Thore-Krug/Dev_Kit-Hardware/README.md

# Dev_Kit-Hardware

The C.H.I.P. Pro Dev Kit integrates a C.H.I.P. Pro. 
More information on C.H.I.P Pro can be found here: [C.H.I.P Pro - Hardware](https://github.com/NextThingCo/CHIP_Pro-Hardware)
