Thore-Krug/Dev_Kit-Hardware/Mechanical/Dev-Kit-v1.0-Mechanical_Diagram.png

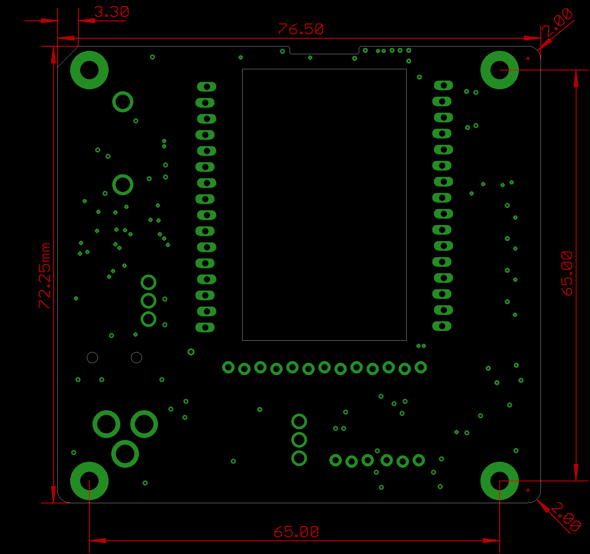
Mechanical/Dev-Kit-v1.0-Mechanical_Diagram.png
