Thore-Krug/Dev_Kit-Hardware/DXF/CHIP_PRO-Dev-Kit-v1.0-outline.dxf

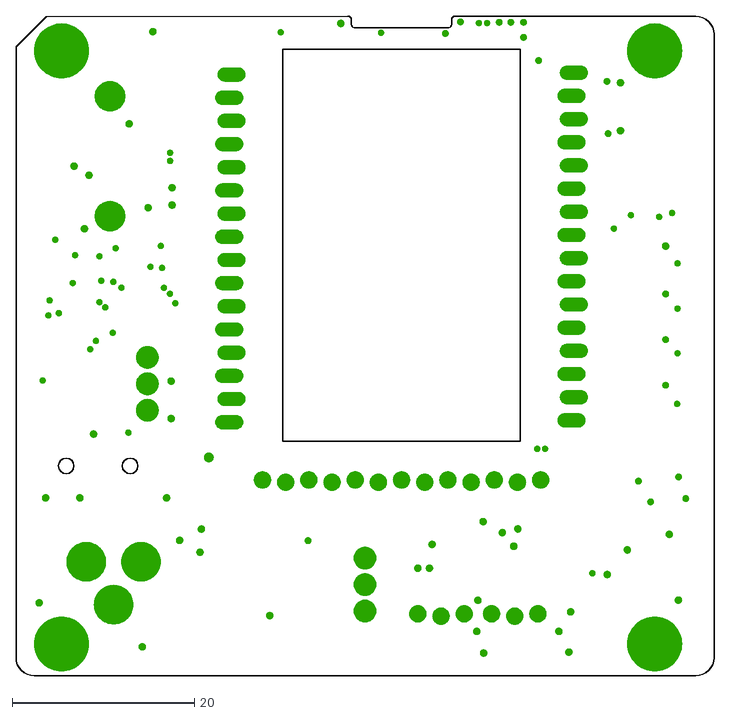
[picture p2: CAD file, 2016-12-20]
DXF/CHIP_PRO-Dev-Kit-v1.0-outline.dxf
76.5 x 72.3
