Thore-Krug/Dev_Kit-Hardware/PDFs/CHIP_PRO-Dev-Kit-v1.0-Schematic.pdf

2

1

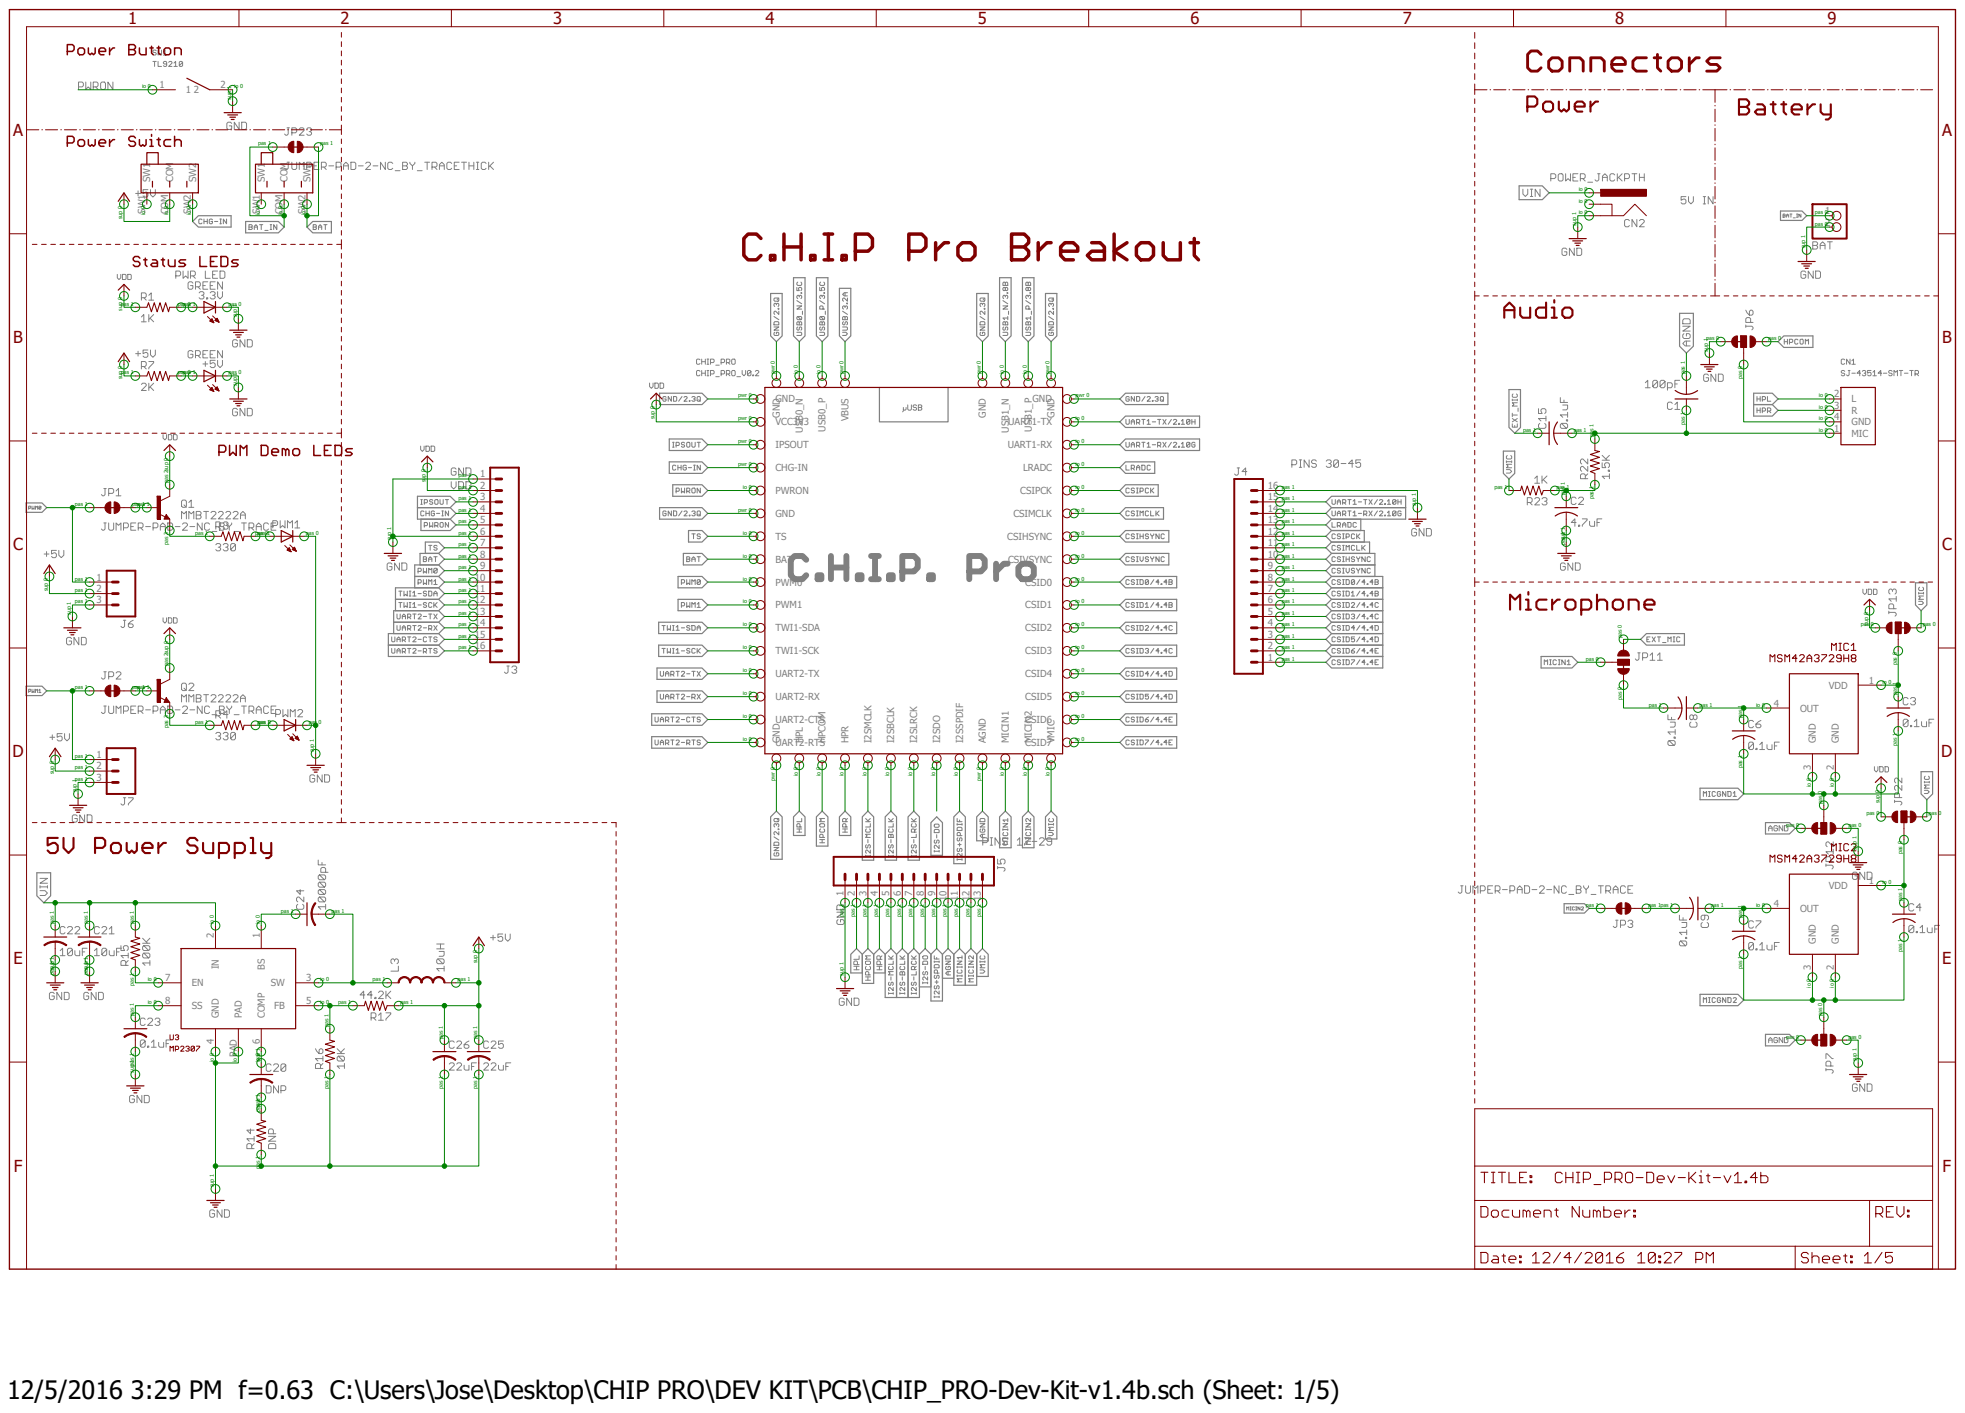
[picture p3: page 1]
AGND; BAT; CHG-IN; CSID0; CSID1; CSID2; CSID3; CSID4; CSID5; CSID6; CSID7; CSIHSYNC; CSIMCLK; CSIPCK; CSIVSYNC; GND; VBUS; GNDGND GND; HPL; HPCOM; HPR; I2SMCLK; I2SBCLK; I2SLRCK; I2SDO; I2SSPDIF; LRADC; MICIN1; MICIN2; PWM0; PWM1; PWRON; TWI1-SCK; TWI1-SDA; UART1-RX; UART1-TX; UART2-CTS; UART2-RTS; UART2-RX; UART2-TX; USB0_N; USB0_P; USB1_N; USB1_P VCC3V3; IPSOUT; VMIC; COMP; PAD PAD; L 2 R 3 GND 4 MIC 1; VDD; OUT 4; COM COM; pas 1; pas 0; sup 1; pas 0 pas 1; pwr 0; sup 0; pas 3 pas 2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

pas 1 pas 1pas 1 pas 1

7 pas 1 8 pas 1

pas 0 pas 0 pas 0

pas 1 pas 1

pas 1 pas 1 sup 1

sup 0 pas 1 pas 1

12/5/2016 3:29 PM f=0.63 C:\Users\Jose\Desktop\CHIP PRO\DEV KIT\PCB\CHIP_PRO-Dev-Kit-v1.4b.sch (Sheet: 1/5)

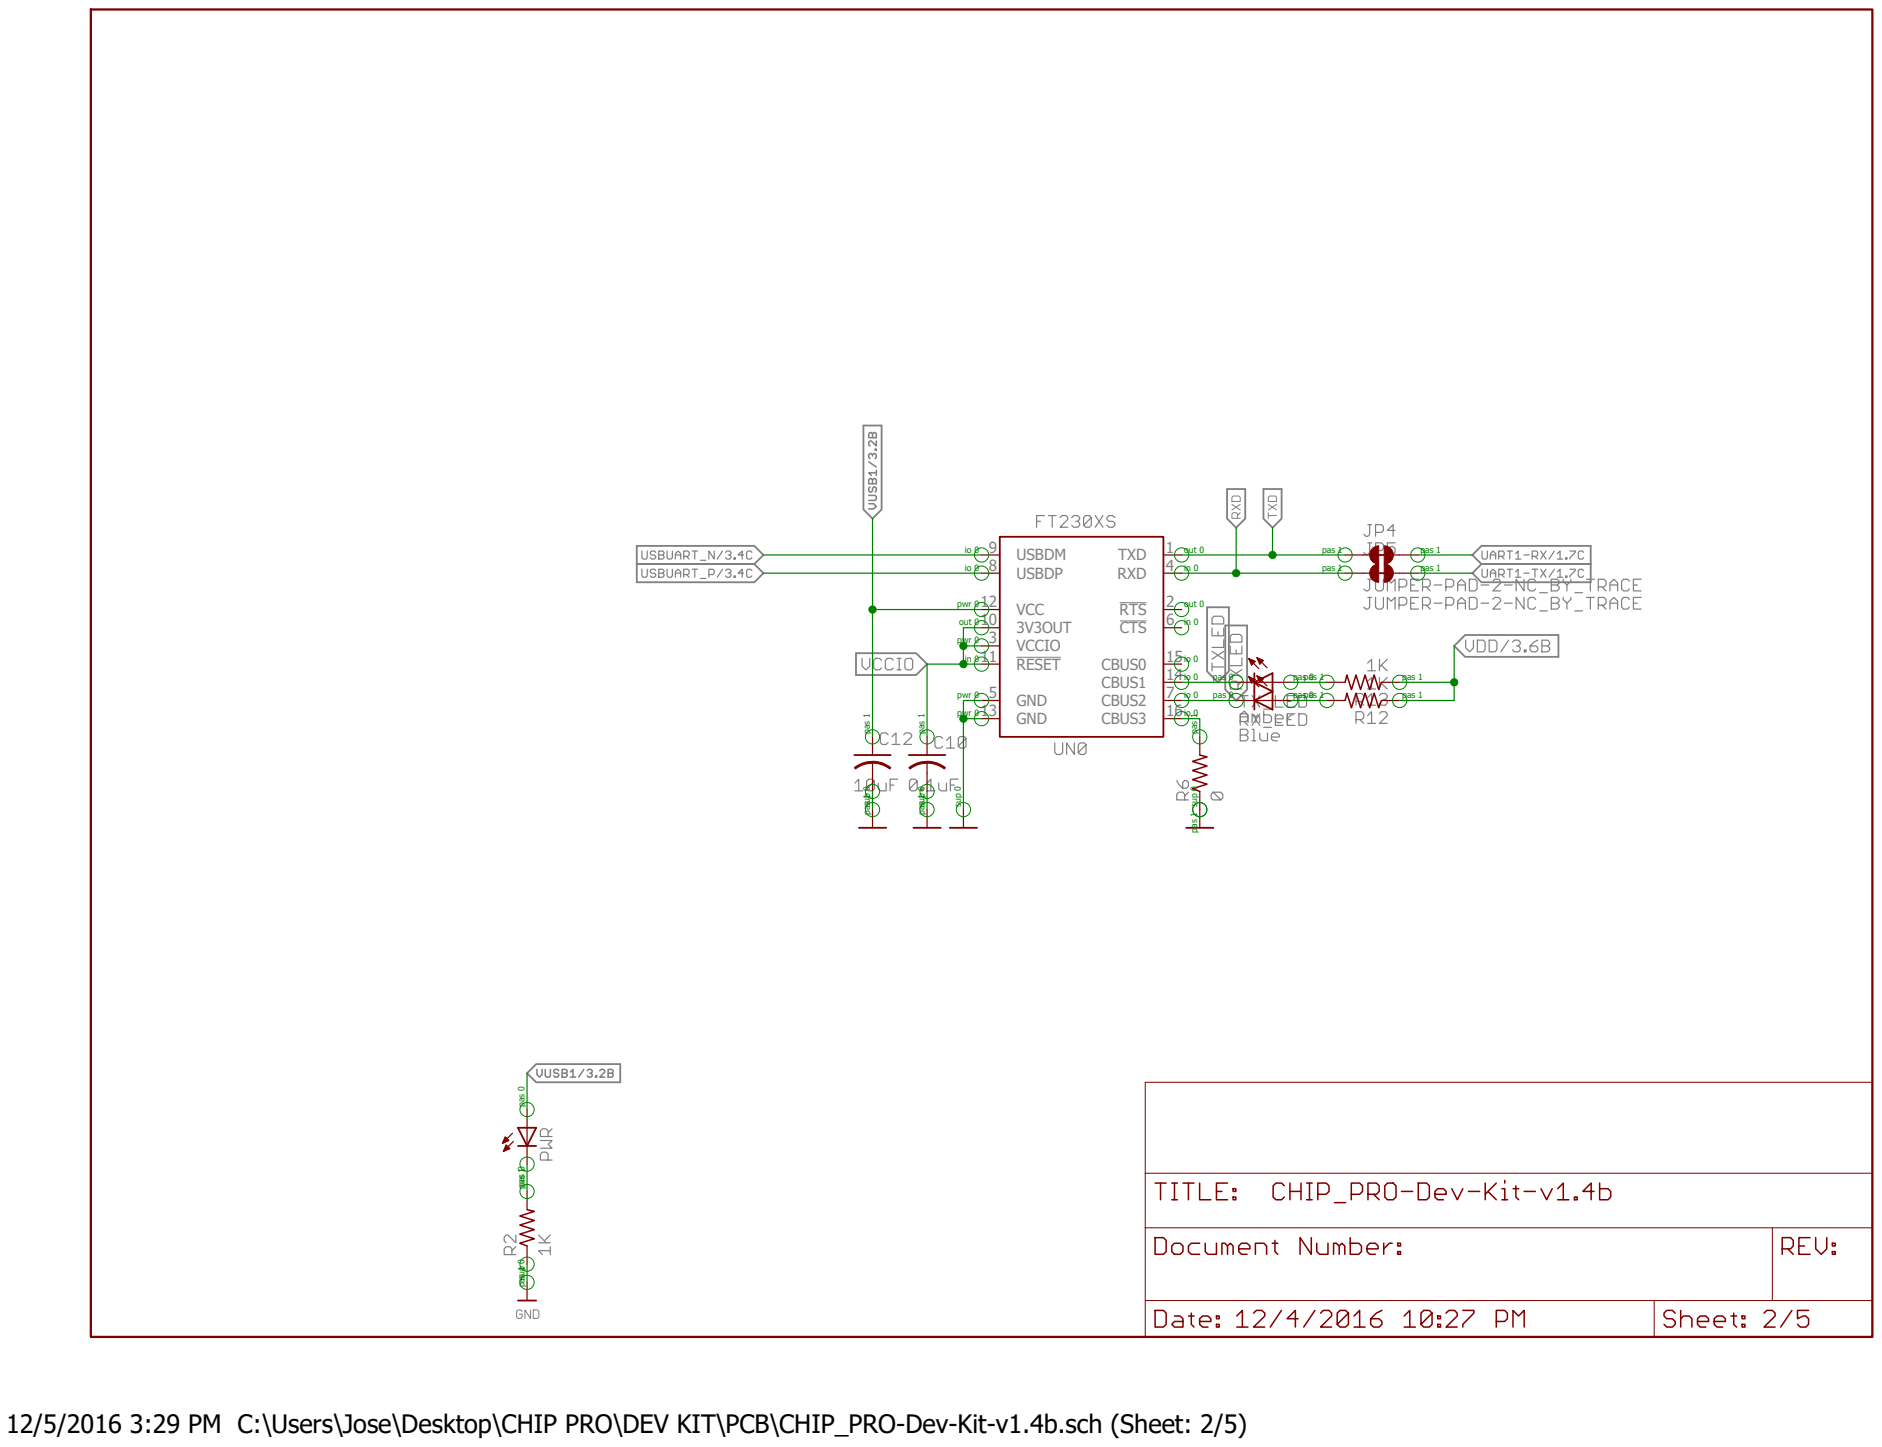
[picture p4: page 2]
VCC 12 3V3OUT 10; USBDP 8 USBDM 9; GND 5; TXD 1 RXD 4; RTS 2 CTS 6; CBUS0 15 CBUS1 14 CBUS2 7 CBUS3 16; VCCIO 3 RESET 11; GND 13; pas 0; pas 0pas 1; pas 1; sup 0; pwr 0; out 0

pas 1 pas 1 sup 0

sup 0 pas 1 pas 1

pas 1 pas 1 pas 0 pas 0

12/5/2016 3:29 PM C:\Users\Jose\Desktop\CHIP PRO\DEV KIT\PCB\CHIP_PRO-Dev-Kit-v1.4b.sch (Sheet: 2/5)

D+

D-

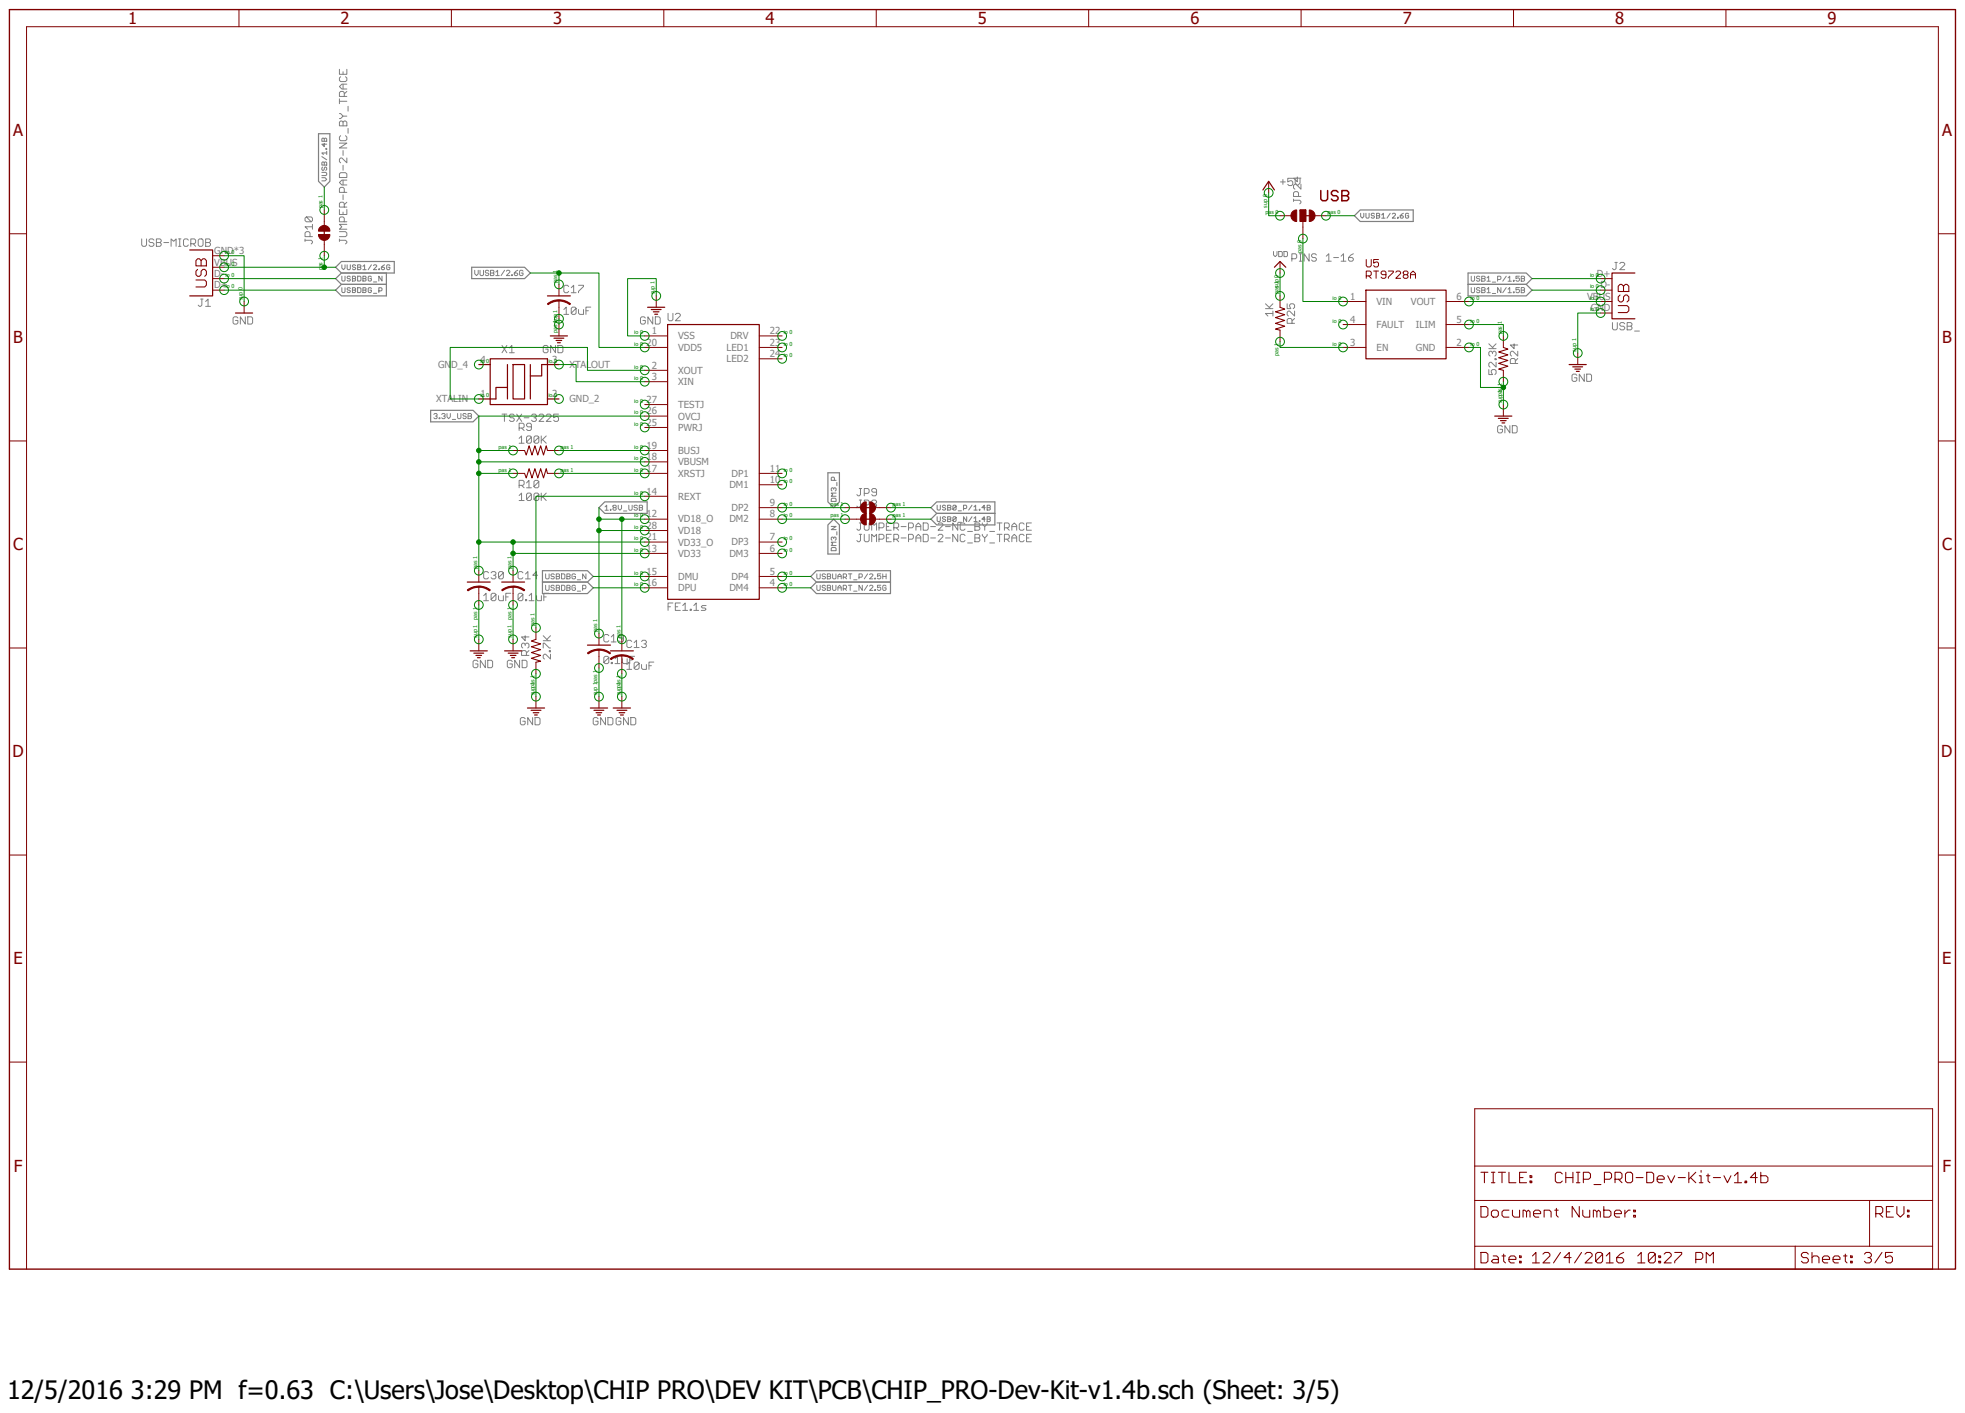
[picture p5: page 3]
VIN 1; FAULT 4; GND; ILIM; VOUT; D- VBUS GND; VSS 1 VDD5 20; XOUT 2 XIN 3; TESTJ 27 OVCJ 26 PWRJ 25; BUSJ 19 VBUSM 18 XRSTJ 17; DRV; LED1; LED2; DMU 15; DPU 16; REXT 14; XTALIN 1; GND_2 2; XTALOUT 3 GND_4 4; VBUS; GND*3; sup 1; sup 0; pas 1 pas 1; pas 1; sup 0io 0; pas 1 pas 1sup 1; pas 0

pas 1 pas 1 sup 1

12/5/2016 3:29 PM f=0.63 C:\Users\Jose\Desktop\CHIP PRO\DEV KIT\PCB\CHIP_PRO-Dev-Kit-v1.4b.sch (Sheet: 3/5)

A

A

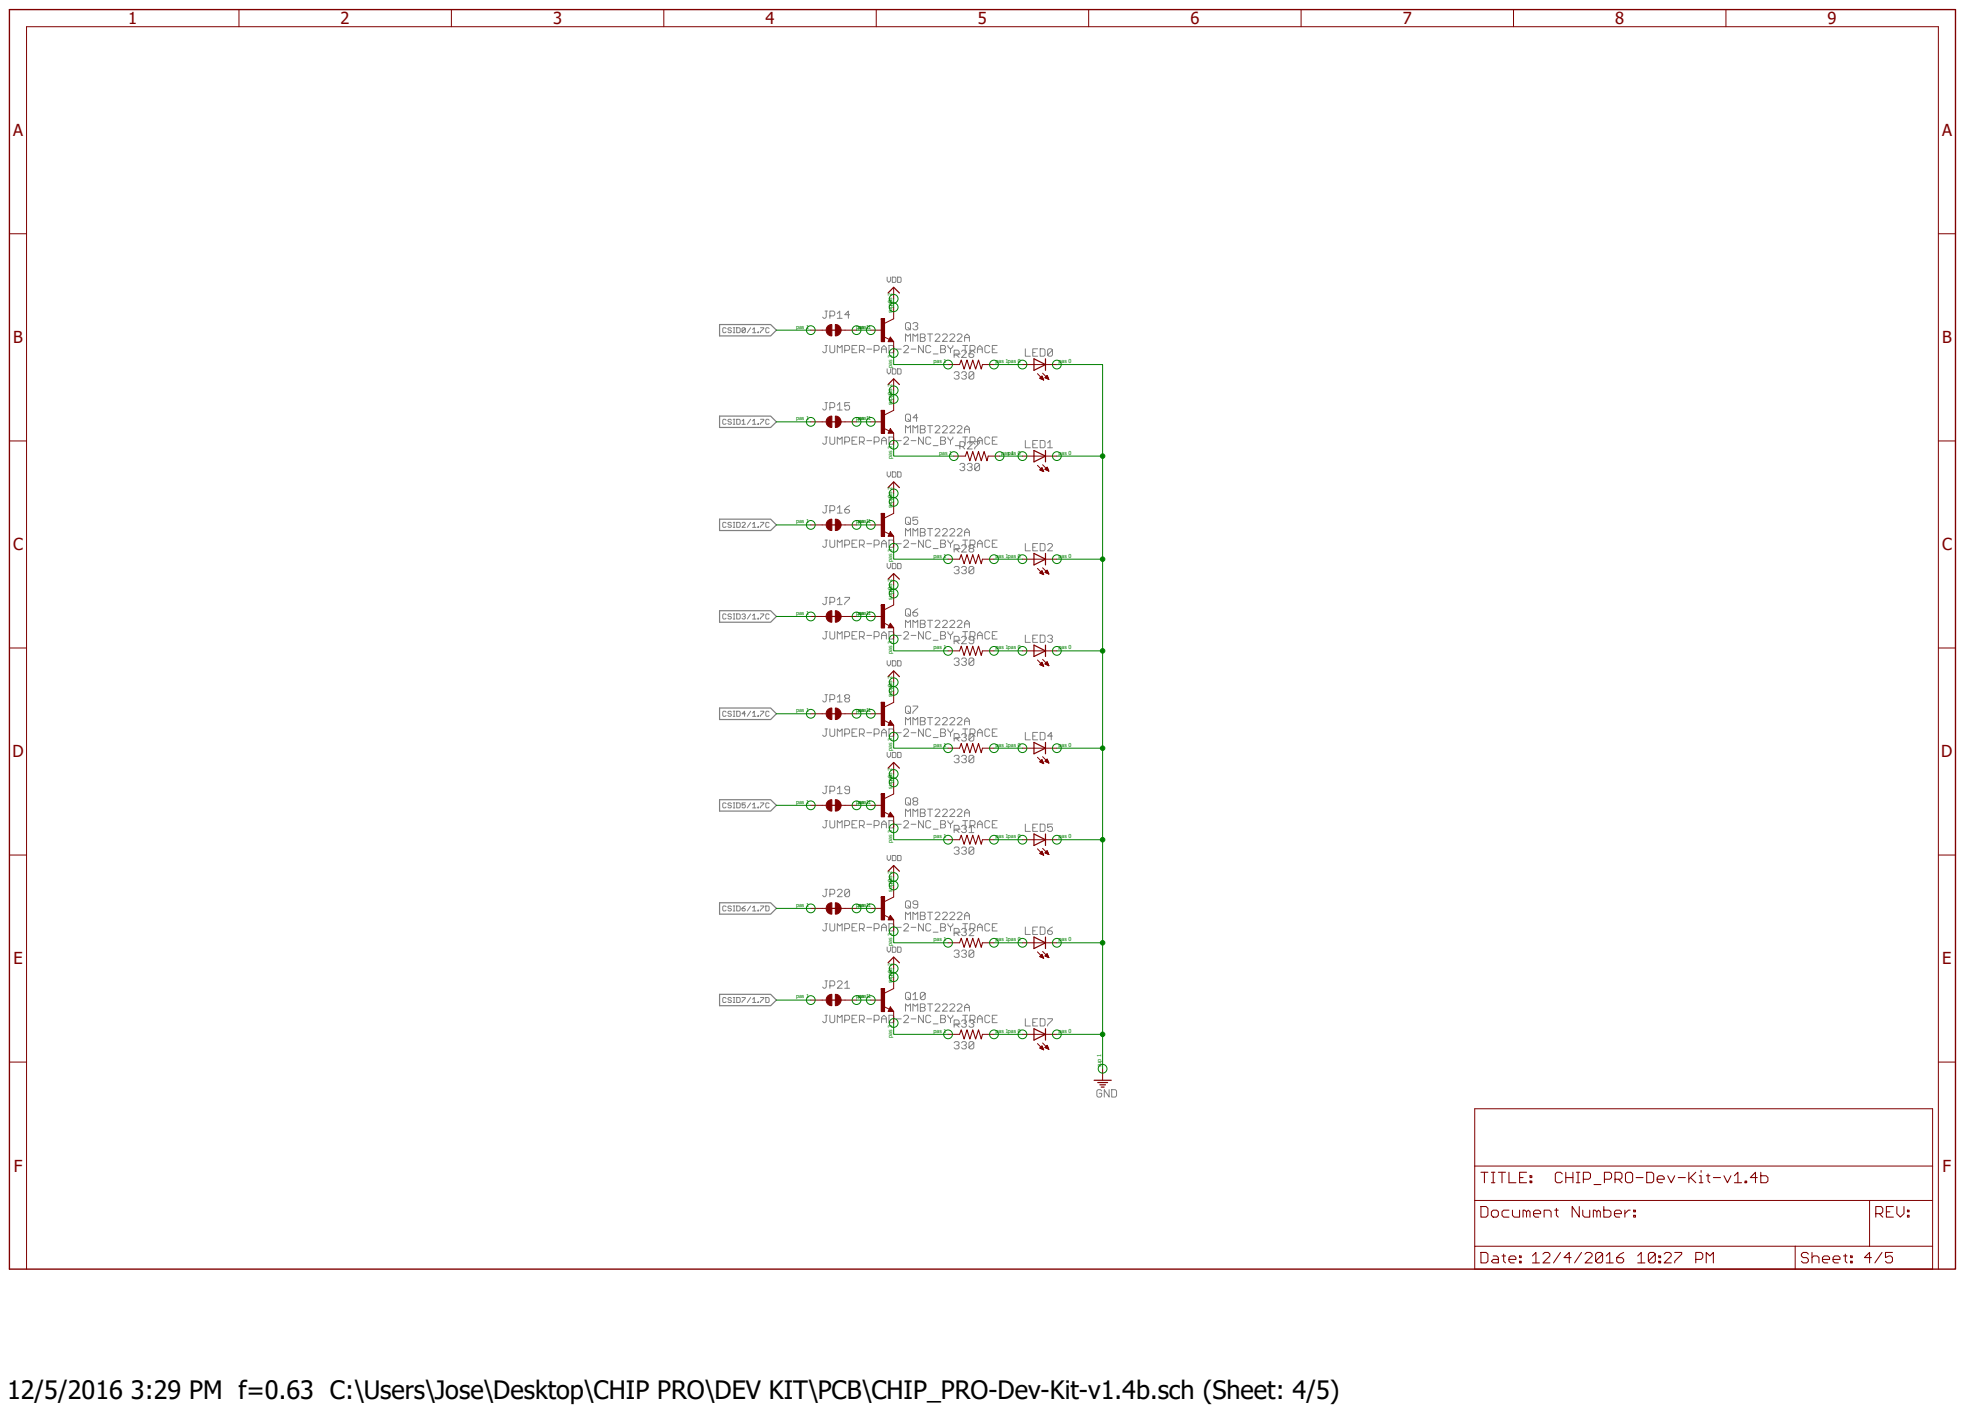
[picture p6: page 4]
pas 1; pas 1pas 0; pas 0; pas 1 pas 1; pas 3 pas 2; sup 1

sup 0 sup 0 sup 0 sup 0

12/5/2016 3:29 PM f=0.63 C:\Users\Jose\Desktop\CHIP PRO\DEV KIT\PCB\CHIP_PRO-Dev-Kit-v1.4b.sch (Sheet: 4/5)
