Thore-Krug/Dev_Kit-Hardware/PDFs/CHIP_PRO-Dev-Kit-v1.0-Stackup.pdf

# Top Copper

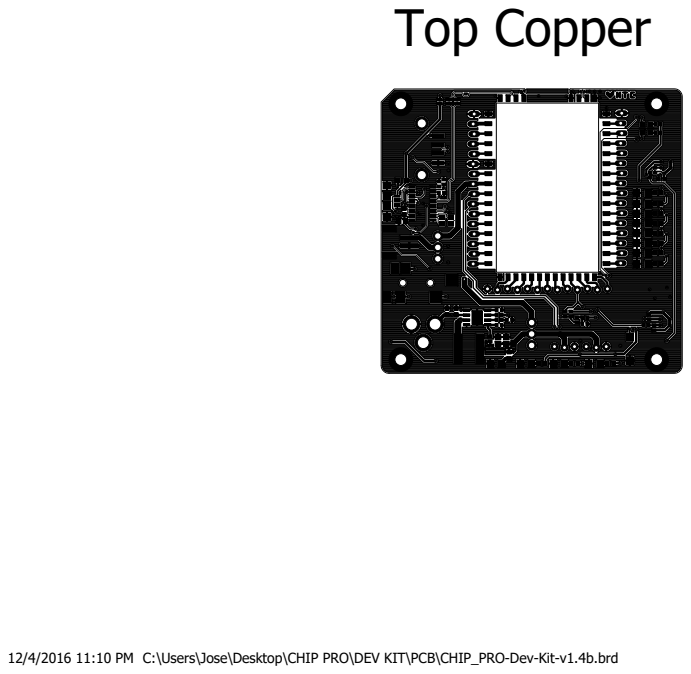
[picture p7: page 1]

12/4/2016 11:10 PM C:\Users\Jose\Desktop\CHIP PRO\DEV KIT\PCB\CHIP_PRO-Dev-Kit-v1.4b.brd

# Bottom Copper

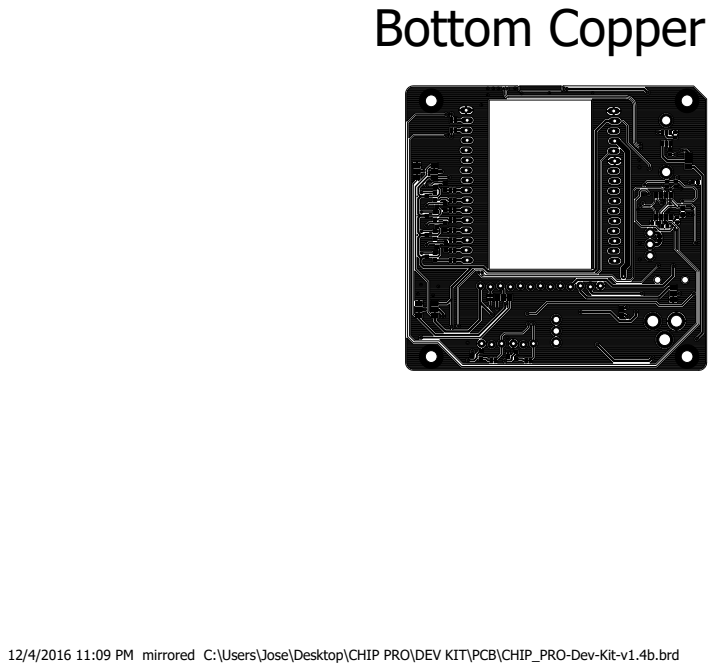
[picture p8: page 2]

12/4/2016 11:09 PM mirrored C:\Users\Jose\Desktop\CHIP PRO\DEV KIT\PCB\CHIP_PRO-Dev-Kit-v1.4b.brd

# Top Silkscreen

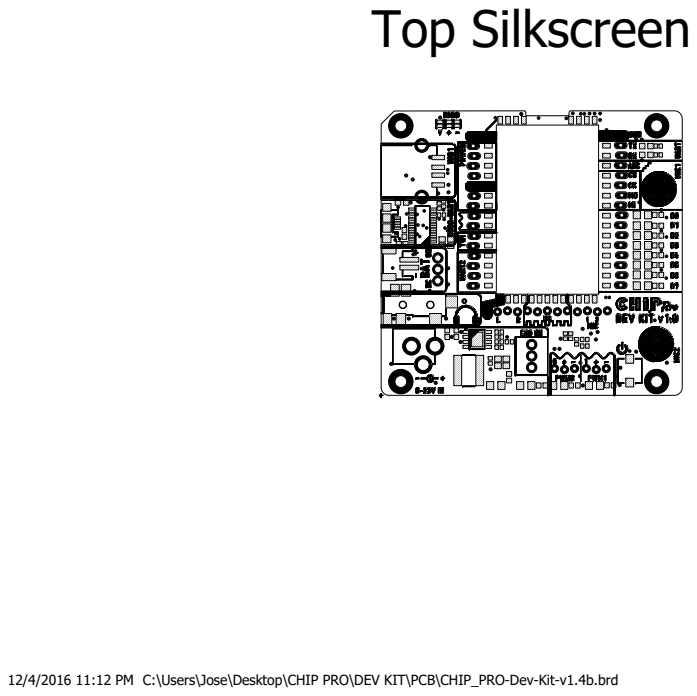
[picture p9: page 3]

12/4/2016 11:12 PM C:\Users\Jose\Desktop\CHIP PRO\DEV KIT\PCB\CHIP_PRO-Dev-Kit-v1.4b.brd

# Bottom Silkscreen

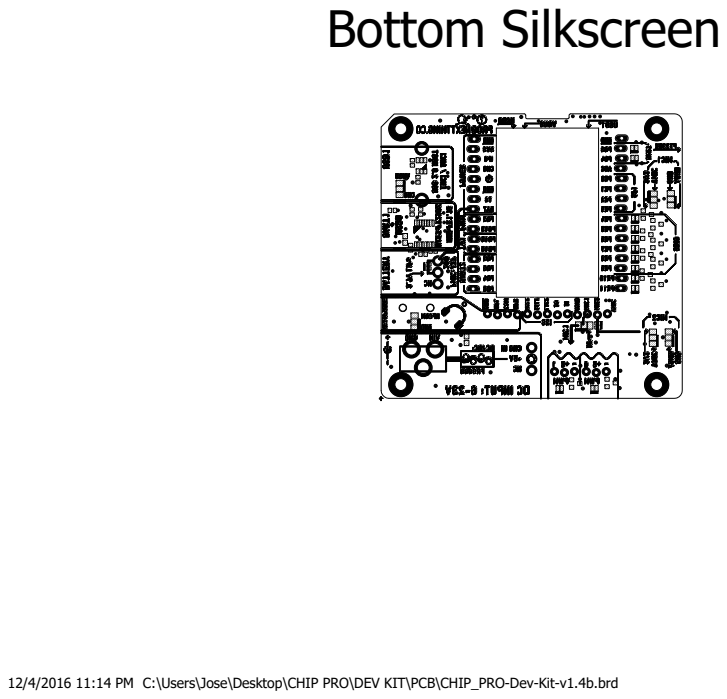
[picture p10: page 4]

12/4/2016 11:14 PM C:\Users\Jose\Desktop\CHIP PRO\DEV KIT\PCB\CHIP_PRO-Dev-Kit-v1.4b.brd
