Thore-Krug/Dev_Kit-Hardware/PCB/CHIP_PRO-Dev-Kit-v1.0.sch

## EAGLE design PCB/CHIP_PRO-Dev-Kit-v1.0.sch (2017-11-18)

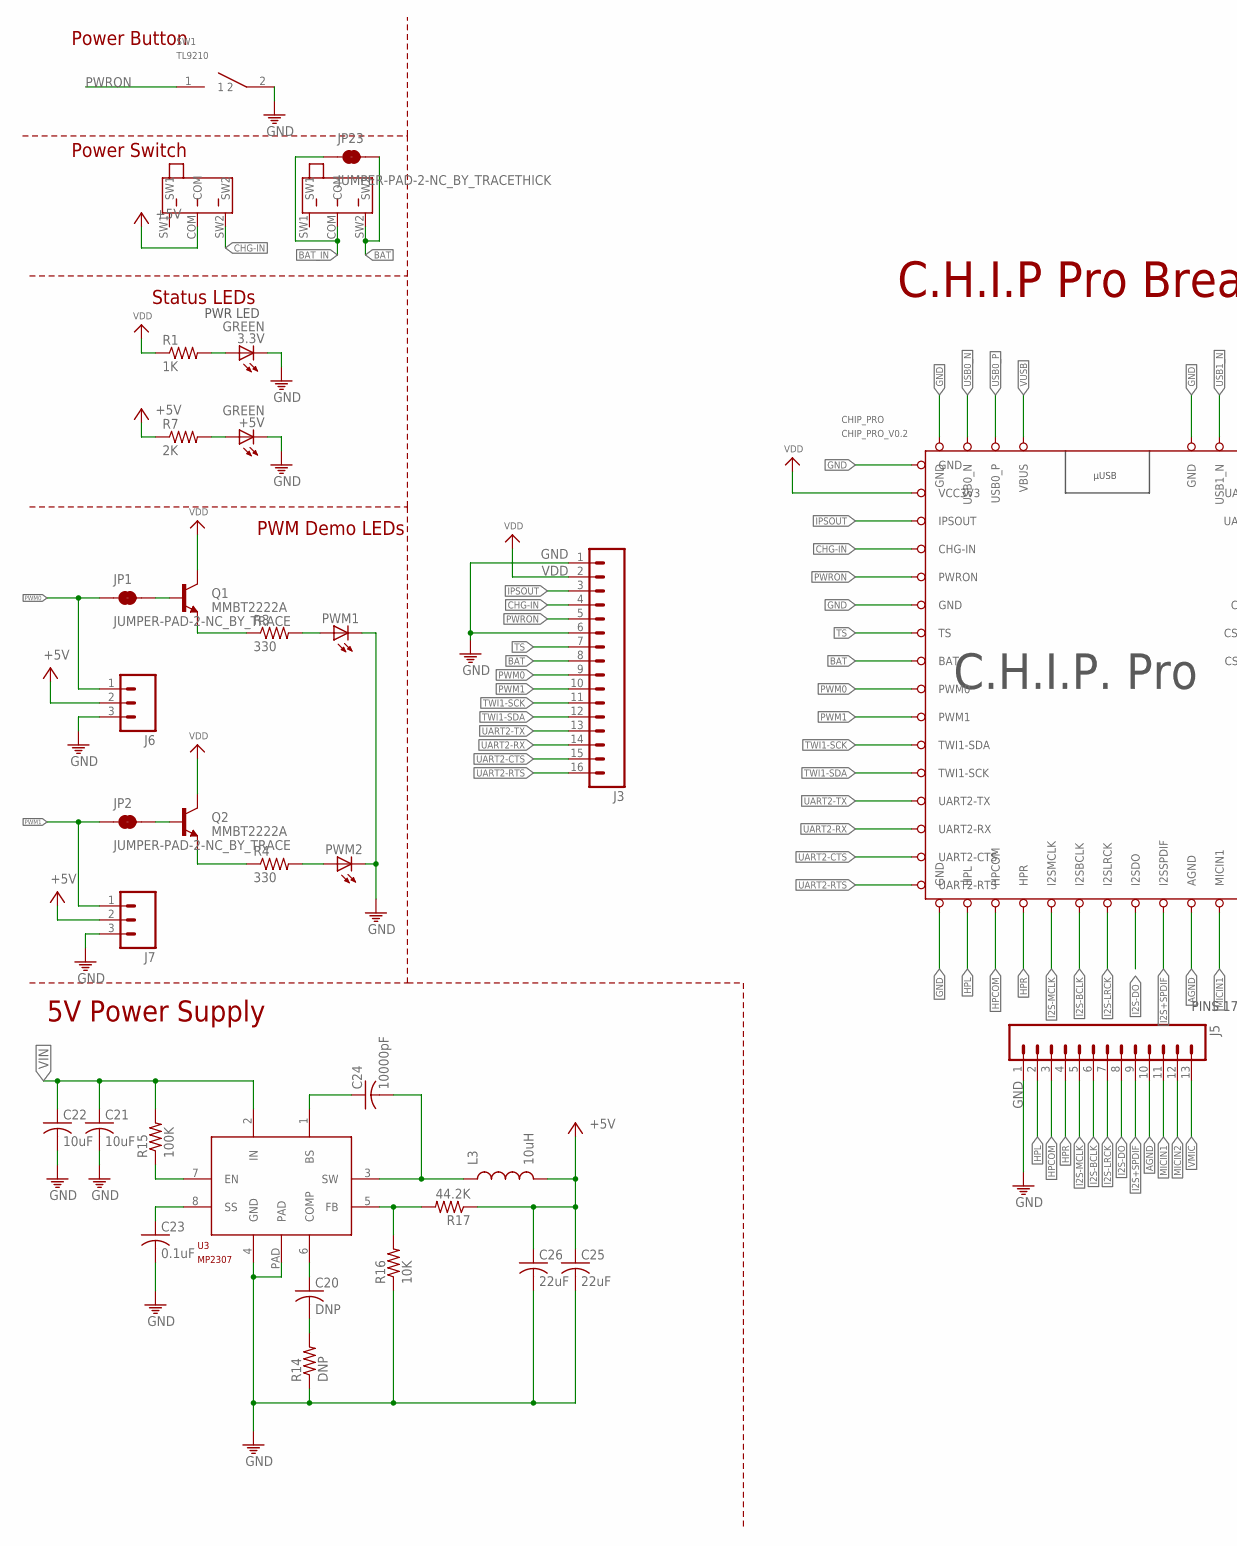
[picture p11: schematic CHIP_PRO-Dev-Kit-v1.0.sch, sheet 1, part in row 1, column 1]

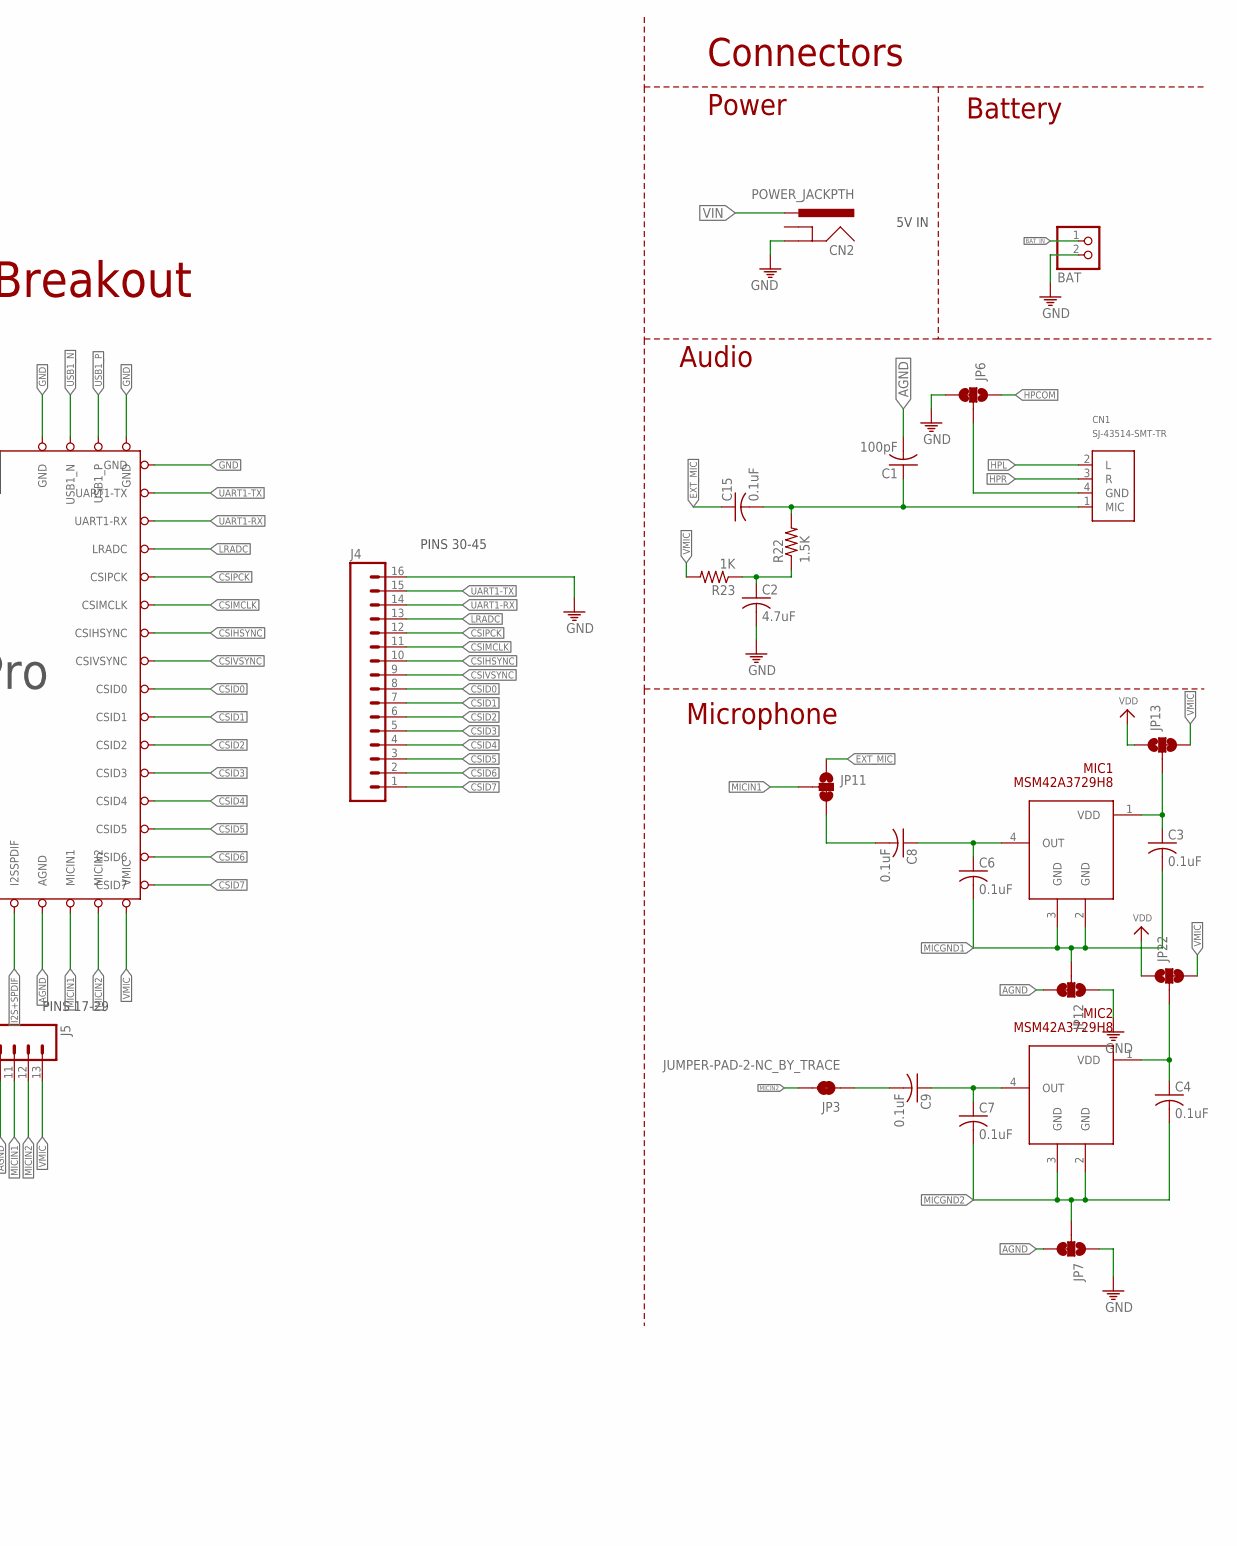
[picture p12: schematic CHIP_PRO-Dev-Kit-v1.0.sch, sheet 1, part in row 1, column 2]

Parts:
3.3V: GREEN; 1206
+5V: GREEN; 1206
BAT: JST_2PIN-SMT-RA; JST-PH-2-SMT-RA
C1: 100pF; C0402
C2: 4.7uF; C0402
C3, C4, C6, C7, C8, C9, C15, C23: 0.1uF; C0402
C20: DNP; C0402
C21, C22: 10uF; C0603
C24: 10000pF; C0603
C25, C26: 22uF; C0805
CHIP_PRO: CHIP_PRO_V0.2; GR8_MODULE_V0.2
CN1: SJ-43514-SMT-TR
CN2: POWER_JACKPTH; POWER_JACK_PTH
J3, J4: M16LOCK_LONGPADS; 1X16_LOCK_LONGPADS
J5: M13LOCK; 1X13_LOCK
J6, J7: M03LOCK; 1X03_LOCK
JP1, JP2, JP3: JUMPER-PAD-2-NC_BY_TRACE; PAD-JUMPER-2-NC_BY_TRACE_YES_SILK
JP6, JP7, JP11, JP12, JP13, JP22: JUMPER-PAD-3-2OF3_NC_BY_TRACE_LARGE; PAD-JUMPER-3-2OF3_NC_BY_TRACE_YES_SILK_LARGE
JP23: JUMPER-PAD-2-NC_BY_TRACETHICK; PAD-JUMPER-2-NC_BY_TRACE_YES_SILK_THICK
L3: 10uH; INDUCTOR_NR8040
MIC1, MIC2: MSM42A3729H8
PWM1, PWM2: LEDSMT1206; 1206
Q1, Q2: MMBT2222A; SOT23-3
R1: 1K; R0603
R3, R4: 330; R0603
R7: 2K; R0603
R14: DNP; R0402
R15: 100K; R0402
R16: 10K; R0402
R17: 44.2K; R0402
R22: 1.5K; R0402
R23: 1K; R0402
SW1: TL9210; TL9210_SW
SW2, SW3: SLIDE_SWITCHESYSS-19-1202-N; YSS-19-1202-N
U3: MP2307; SOIC-8-PAD

Connections:
+5V: C25.1, C26.1, J6.2, J7.2, L3.P$2 (2), R7.1, R17.1, SW2.COM
AGND: C1.2, CHIP_PRO.AGND, J5.10, JP7.3, JP12.3
BAT: CHIP_PRO.BAT, J3.8, JP23.2, SW3.SW2
BAT_IN: BAT.1 (2), JP23.1, SW3.COM
CHG-IN: CHIP_PRO.CHG-IN, J3.4, SW2.SW2
CSID0: CHIP_PRO.CSID0, J4.8
CSID1: CHIP_PRO.CSID1, J4.7
CSID2: CHIP_PRO.CSID2, J4.6
CSID3: CHIP_PRO.CSID3, J4.5
CSID4: CHIP_PRO.CSID4, J4.4
CSID5: CHIP_PRO.CSID5, J4.3
CSID6: CHIP_PRO.CSID6, J4.2
CSID7: CHIP_PRO.CSID7, J4.1
CSIHSYNC: CHIP_PRO.CSIHSYNC, J4.10
CSIMCLK: CHIP_PRO.CSIMCLK, J4.11
CSIPCK: CHIP_PRO.CSIPCK, J4.12
CSIVSYNC: CHIP_PRO.CSIVSYNC, J4.9
EXT_MIC: C15.1, JP11.1
GND: 3.3V.C, +5V.C, BAT.2 (1), C2.2, C21.2, C22.2, C23.2, C25.2, C26.2, CHIP_PRO.GND@0 (GND), CHIP_PRO.GND@1 (GND), CHIP_PRO.GND@2 (GND), CHIP_PRO.GND@3 (GND), CHIP_PRO.GND@4 (GND), CHIP_PRO.GND@6 (GND), CHIP_PRO.GND@7 (GND), CN2.GND, J3.1, J3.6, J4.16, J5.1, J6.3, J7.3, JP6.3, JP7.1, JP12.1, PWM1.C, PWM2.C, R14.1, R16.1, SW1.2, U3.4 (GND), U3.PAD
HPCOM: CHIP_PRO.HPCOM, J5.3, JP6.1
HPL: CHIP_PRO.HPL, CN1.2 (L), J5.2
HPR: CHIP_PRO.HPR, CN1.3 (R), J5.4
I2S+SPDIF: CHIP_PRO.I2S+SPDIF (I2SSPDIF), J5.9
I2S-BCLK: CHIP_PRO.I2S-BCLK (I2SBCLK), J5.6
I2S-DO: CHIP_PRO.I2S-DO (I2SDO), J5.8
I2S-LRCK: CHIP_PRO.I2S-LRCK (I2SLRCK), J5.7
I2S-MCLK: CHIP_PRO.I2S-MCLK (I2SMCLK), J5.5
IPSOUT: CHIP_PRO.IPSOUT, J3.3
LRADC: CHIP_PRO.LRADC, J4.13
MICGND1: C3.2, C6.2, JP12.2, MIC1.2 (GND), MIC1.3 (GND)
MICGND2: C4.2, C7.2, JP7.2, MIC2.2 (GND), MIC2.3 (GND)
MICIN1: CHIP_PRO.MICIN1, J5.11, JP11.2
MICIN2: CHIP_PRO.MICIN2, J5.12, JP3.2
unnamed: 3.3V.A, R1.2
unnamed: C3.1, JP13.2, MIC1.1 (VDD)
unnamed: C6.1, C8.1, MIC1.4 (OUT)
unnamed: JP1.2, Q1.1 (B)
unnamed: JP2.2, Q2.1 (B)
unnamed: C8.2, JP11.3
unnamed: Q1.2 (E), R3.1
unnamed: PWM1.A, R3.2
unnamed: Q2.2 (E), R4.1
unnamed: PWM2.A, R4.2
unnamed: R15.1, U3.7 (EN)
unnamed: C23.1, U3.8 (SS)
unnamed: CN1.4 (GND), JP6.2
unnamed: C20.2, R14.2
unnamed: C20.1, U3.6 (COMP)
unnamed: C24.1, U3.1 (BS)
unnamed: C24.2, L3.P$1 (1), U3.3 (SW)
unnamed: C1.1, C15.2, CN1.1 (MIC), R22.2
unnamed: R16.2, R17.2, U3.5 (FB)
unnamed: C2.1, R22.1, R23.1
unnamed: +5V.A, R7.2
unnamed: C7.1, C9.1, MIC2.4 (OUT)
unnamed: C4.1, JP22.2, MIC2.1 (VDD)
unnamed: C9.2, JP3.1
PWM0: CHIP_PRO.PWM0, J3.9, J6.1, JP1.1
PWM1: CHIP_PRO.PWM1, J3.10, J7.1, JP2.1
PWRON: CHIP_PRO.PWRON, J3.5, SW1.1
TS: CHIP_PRO.TS, J3.7
TWI1-SCK: CHIP_PRO.TWI1-SDA, J3.11
TWI1-SDA: CHIP_PRO.TWI1-SCK, J3.12
UART1-RX: CHIP_PRO.UART1-RX, J4.14
UART1-TX: CHIP_PRO.UART1-TX, J4.15
UART2-CTS: CHIP_PRO.UART2-CTS, J3.15
UART2-RTS: CHIP_PRO.UART2-RTS, J3.16
UART2-RX: CHIP_PRO.UART2-RX, J3.14
UART2-TX: CHIP_PRO.UART2-TX, J3.13
USB0_N: CHIP_PRO.USB0_N
USB0_P: CHIP_PRO.USB0_P
USB1_N: CHIP_PRO.USB1_N
USB1_P: CHIP_PRO.USB1_P
VDD: CHIP_PRO.VCC3V3, J3.2, JP13.1, JP22.1, Q1.3 (C), Q2.3 (C), R1.1
VIN: C21.1, C22.1, CN2.PWR, R15.2, U3.2 (IN)
VMIC: CHIP_PRO.VMIC, J5.13, JP13.3, JP22.3, R23.2
VUSB: CHIP_PRO.VBUS

Notes on the sheet:
PINS 30-45
PINS 17-29
PWR LED
5V IN
Status LEDs
Power Button
Connectors
Power
C.H.I.P Pro Breakout
Microphone
Audio
Battery
5V Power Supply
PWM Demo LEDs
Power Switch

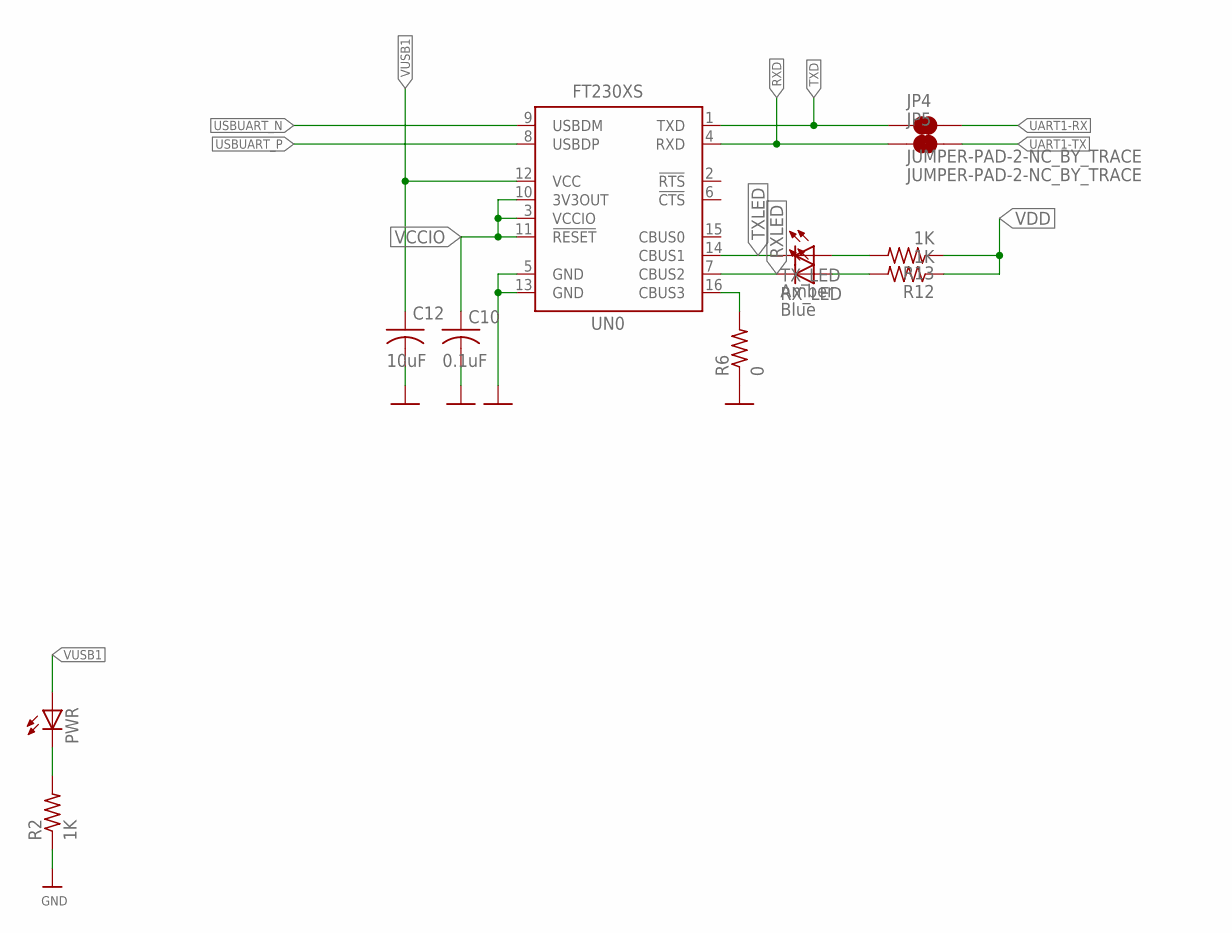
[picture p13: schematic CHIP_PRO-Dev-Kit-v1.0.sch, sheet 2]

Parts:
C10: 0.1uF; C0402
C12: 10uF; C0402
JP4, JP5: JUMPER-PAD-2-NC_BY_TRACE; PAD-JUMPER-2-NC_BY_TRACE_YES_SILK
PWR: LED805; LED-805
R2, R12, R13: 1K; R0402
R6: 0; R0402
RX_LED: Blue; LED-805
TX_LED: Amber; LED-805
UN0: FT230XS; SSOP-16

Connections:
GND: C10.2, C12.2, R2.1, R6.1, UN0.5 (GND), UN0.13 (GND)
unnamed: PWR.C, R2.2
unnamed: R12.2, RX_LED.A
unnamed: R13.2, TX_LED.A
unnamed: R6.2, UN0.16 (CBUS3)
RXD: JP5.1, UN0.4 (RXD)
RXLED: RX_LED.C, UN0.7 (CBUS2)
TXD: JP4.1, UN0.1 (TXD)
TXLED: TX_LED.C, UN0.14 (CBUS1)
UART1-RX: JP4.2
UART1-TX: JP5.2
USBUART_N: UN0.9 (USBDM)
USBUART_P: UN0.8 (USBDP)
VCCIO: C10.1, UN0.3 (VCCIO), UN0.10 (3V3OUT), UN0.11 (!RESET)
VDD: R12.1, R13.1
VUSB1: C12.1, PWR.A, UN0.12 (VCC)

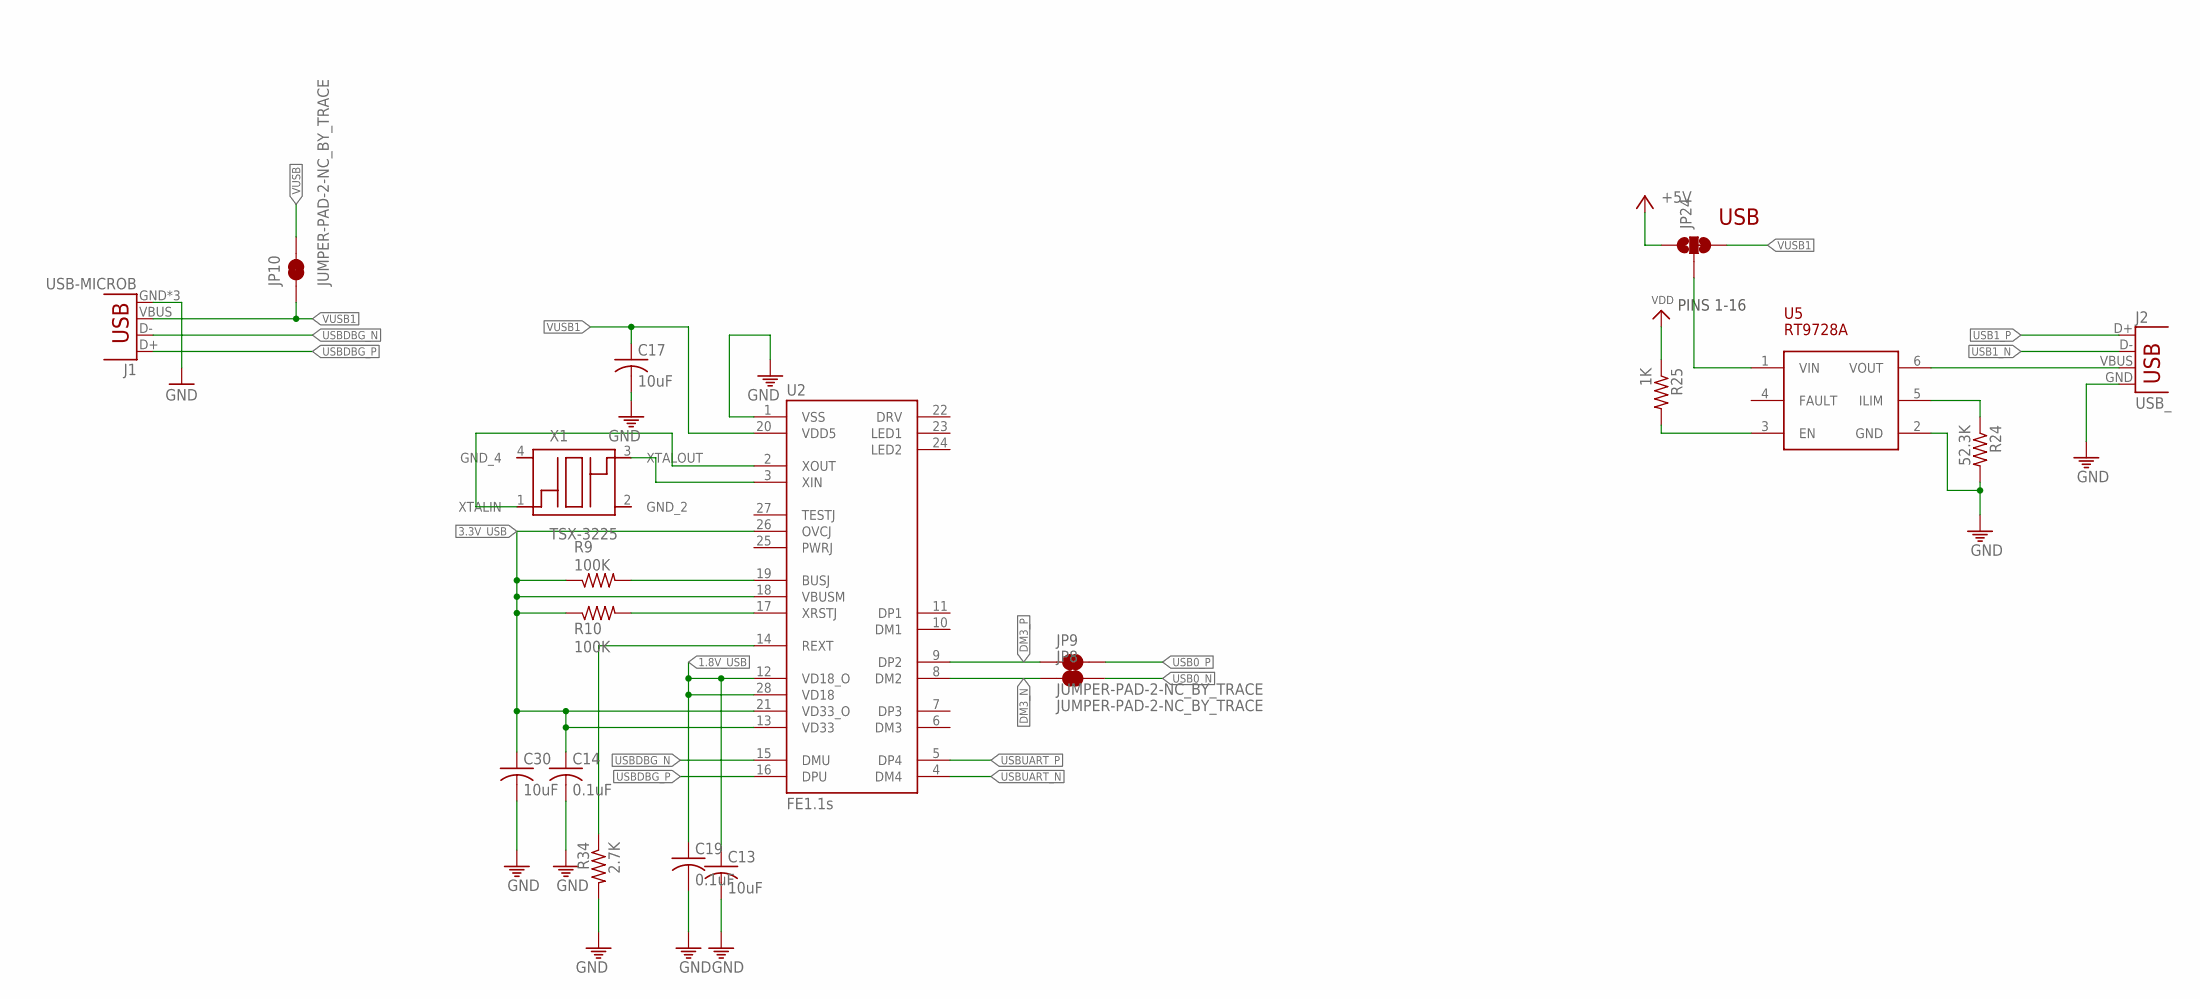
[picture p14: schematic CHIP_PRO-Dev-Kit-v1.0.sch, sheet 3]

Parts:
C13, C17, C30: 10uF; C0603
C14, C19: 0.1uF; C0402
J1: USB-MICROB
J2: USB_; USB-A-S-SILK-FEMALE
JP8, JP9, JP10: JUMPER-PAD-2-NC_BY_TRACE; PAD-JUMPER-2-NC_BY_TRACE_YES_SILK
JP24: JUMPER-PAD-3-2OF3_NC_BY_TRACE_LARGE; PAD-JUMPER-3-2OF3_NC_BY_TRACE_YES_SILK_LARGE
R9, R10: 100K; R0402
R24: 52.3K; R0402
R25: 1K; R0402
R34: 2.7K; R0402
U2: FE1.1S; FE1.1S_SSOP-28
U5: RT9728A; SOT-23-6
X1: TSX-3225

Connections:
1.8V_USB: C13.1, C19.1, U2.12 (VD18_O), U2.28 (VD18)
3.3V_USB: C14.1, C30.1, R9.1, R10.1, U2.13 (VD33), U2.18 (VBUSM), U2.21 (VD33_O), U2.26 (OVCJ)
+5V: JP24.1
DM3_N: JP8.1, U2.8 (DM2)
DM3_P: JP9.1, U2.9 (DP2)
GND: C13.2, C14.2, C17.2, C19.2, C30.2, J1.GND, J2.GND, R24.2, R34.2, U2.1 (VSS), U5.2 (GND)
unnamed: R9.2, U2.19 (BUSJ)
unnamed: JP24.2, U5.1 (VIN)
unnamed: J2.VBUS, U5.6 (VOUT)
unnamed: R34.1, U2.14 (REXT)
unnamed: U2.3 (XIN), X1.3 (XTALOUT)
unnamed: R10.2, U2.17 (XRSTJ)
unnamed: R25.2, U5.3 (EN)
unnamed: R24.1, U5.5 (ILIM)
unnamed: U2.2 (XOUT), X1.1 (XTALIN)
USB0_N: JP8.2
USB0_P: JP9.2
USB1_N: J2.D-
USB1_P: J2.D+
USBDBG_N: J1.D-, U2.15 (DMU)
USBDBG_P: J1.D+, U2.16 (DPU)
USBUART_N: U2.4 (DM4)
USBUART_P: U2.5 (DP4)
VDD: R25.1
VUSB: JP10.2
VUSB1: C17.1, J1.VBUS, JP10.1, JP24.3, U2.20 (VDD5)

Notes on the sheet:
USB
PINS 1-16

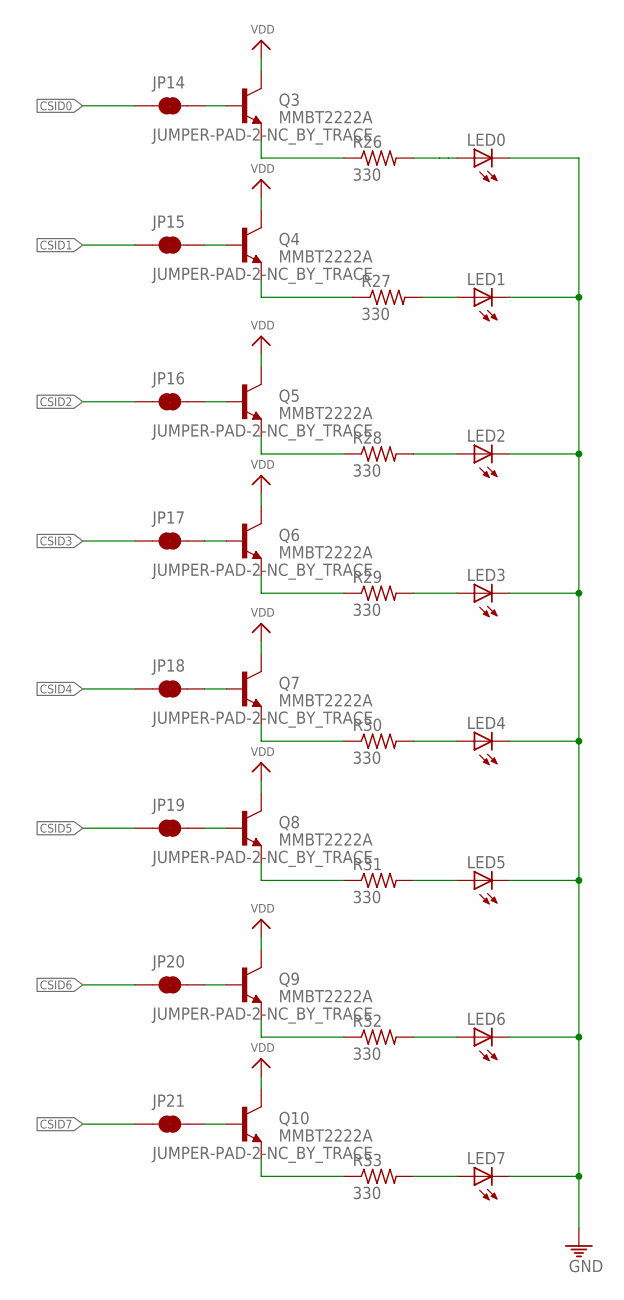
[picture p15: schematic CHIP_PRO-Dev-Kit-v1.0.sch, sheet 4]

Parts:
JP14, JP15, JP16, JP17, JP18, JP19, JP20, JP21: JUMPER-PAD-2-NC_BY_TRACE; PAD-JUMPER-2-NC_BY_TRACE_YES_SILK
LED0, LED1, LED2, LED3, LED4, LED5, LED6, LED7: LEDSMT1206; 1206
Q3, Q4, Q5, Q6, Q7, Q8, Q9, Q10: MMBT2222A; SOT23-3
R26, R27, R28, R29, R30, R31, R32, R33: 330; R0603

Connections:
CSID0: JP14.1
CSID1: JP15.1
CSID2: JP16.1
CSID3: JP17.1
CSID4: JP18.1
CSID5: JP19.1
CSID6: JP20.1
CSID7: JP21.1
GND: LED0.C, LED1.C, LED2.C, LED3.C, LED4.C, LED5.C, LED6.C, LED7.C
unnamed: JP14.2, Q3.1 (B)
unnamed: Q3.2 (E), R26.1
unnamed: JP15.2, Q4.1 (B)
unnamed: Q4.2 (E), R27.1
unnamed: JP16.2, Q5.1 (B)
unnamed: Q5.2 (E), R28.1
unnamed: JP17.2, Q6.1 (B)
unnamed: Q6.2 (E), R29.1
unnamed: JP18.2, Q7.1 (B)
unnamed: Q7.2 (E), R30.1
unnamed: JP19.2, Q8.1 (B)
unnamed: Q8.2 (E), R31.1
unnamed: JP20.2, Q9.1 (B)
unnamed: Q9.2 (E), R32.1
unnamed: JP21.2, Q10.1 (B)
unnamed: Q10.2 (E), R33.1
unnamed: LED7.A, R33.2
unnamed: LED6.A, R32.2
unnamed: LED5.A, R31.2
unnamed: LED4.A, R30.2
unnamed: LED3.A, R29.2
unnamed: LED2.A, R28.2
unnamed: LED1.A, R27.2
unnamed: LED0.A, R26.2
VDD: Q3.3 (C), Q4.3 (C), Q5.3 (C), Q6.3 (C), Q7.3 (C), Q8.3 (C), Q9.3 (C), Q10.3 (C)
