Thore-Krug/Dev_Kit-Hardware/(commit log)

2016-12-20 making the package
    [CHIP_PRO-Dev-Kit-v1.0-outline.dxf]
2016-12-21 Eagle source files
    [CHIP_PRO-Dev-Kit-v1.0.sch]
2017-11-18 update EAGLE library and source to fix errata in github issue #1
    [CHIP_PRO-Dev-Kit-v1.0.sch]
